anacleto-pt/Seismic-Table/README.md

# Seismic-Table
In this repository, you can find a fully detailed seismic table, materials list, and instructions on how to build your own.
