anacleto-pt/Seismic-Table/Mid Term Presentation/image-removebg-preview (2).png

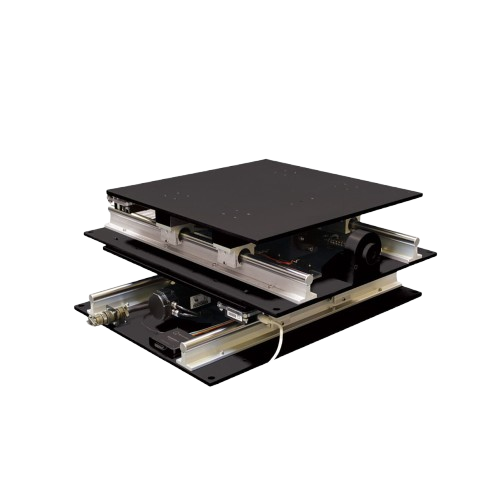
Mid Term Presentation/image-removebg-preview (2).png
