anacleto-pt/Seismic-Table/Sort/Desenho pinos ESP32.png

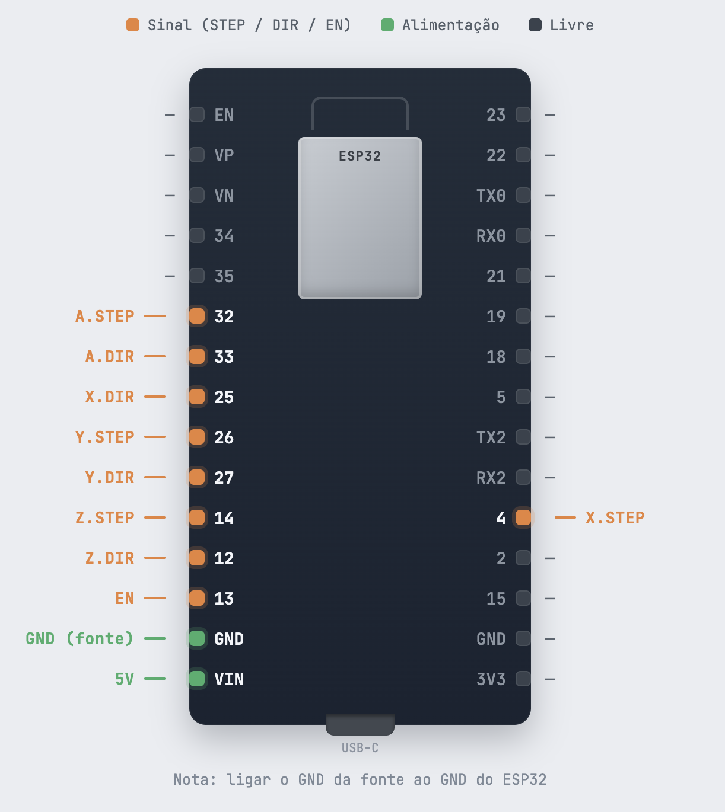
Sort/Desenho pinos ESP32.png
