anacleto-pt/Seismic-Table/Entrega/Partes3D/Base_Movel.stl

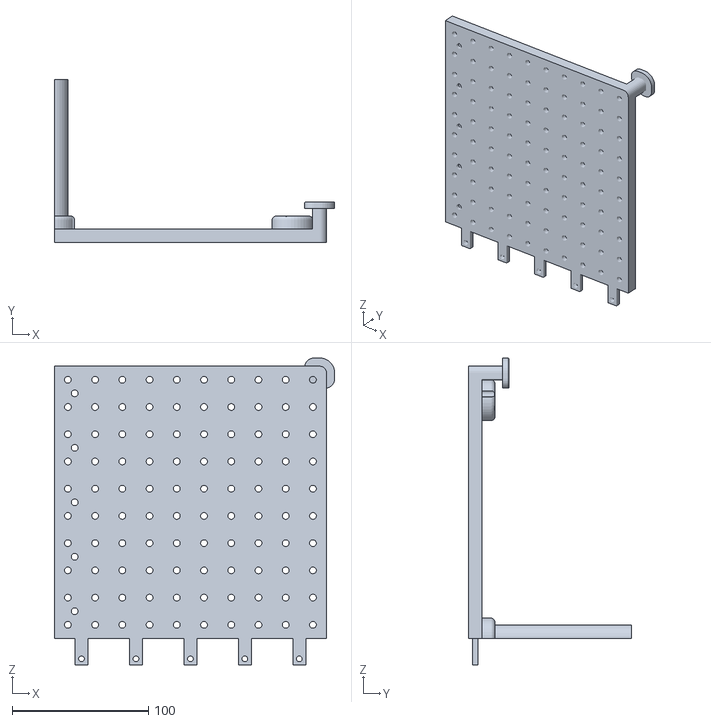
[picture p15: CAD file, 2026-06-26]
Entrega/Partes3D/Base_Movel.stl
206.0 x 120.0 x 225.5
