anacleto-pt/Seismic-Table/Entrega/Partes3D/Base_Fixa_Canto.stl

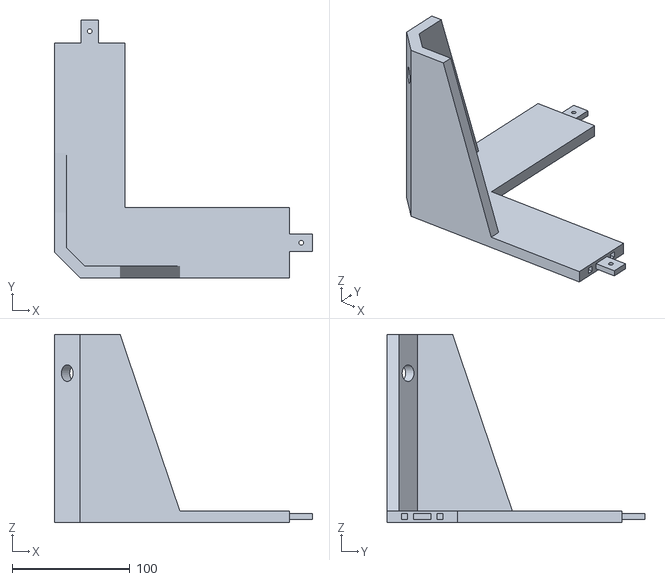
[picture p16: CAD file, 2026-06-26]
Entrega/Partes3D/Base_Fixa_Canto.stl
219.5 x 219.5 x 160.0
