anacleto-pt/Seismic-Table/Entrega/Partes3D/Coluna_Rotula.stl

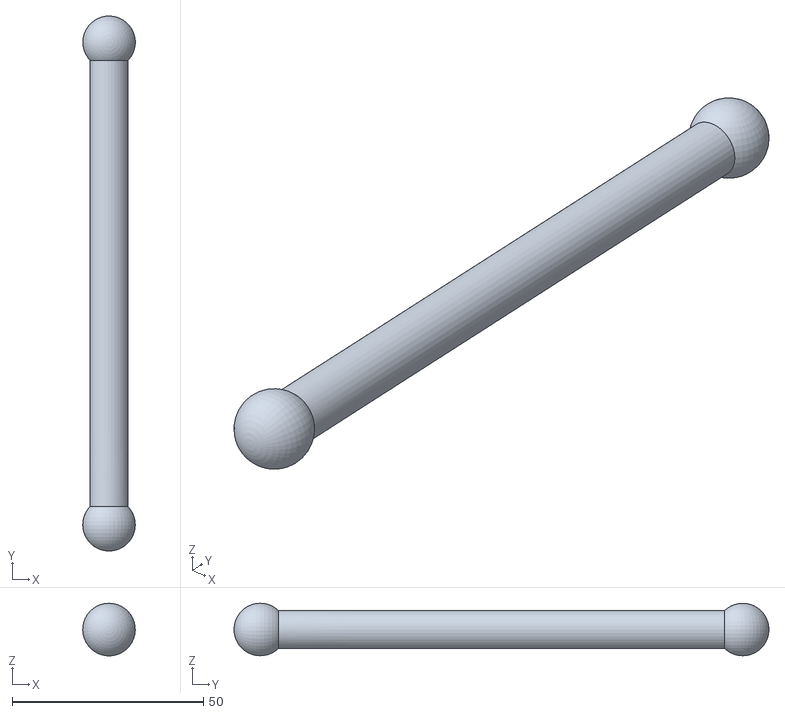
[picture p17: CAD file, 2026-06-26]
Entrega/Partes3D/Coluna_Rotula.stl
13.8 x 140.0 x 13.8
