anacleto-pt/Seismic-Table/Entrega/Partes3D/Suporte_Rotula.stl

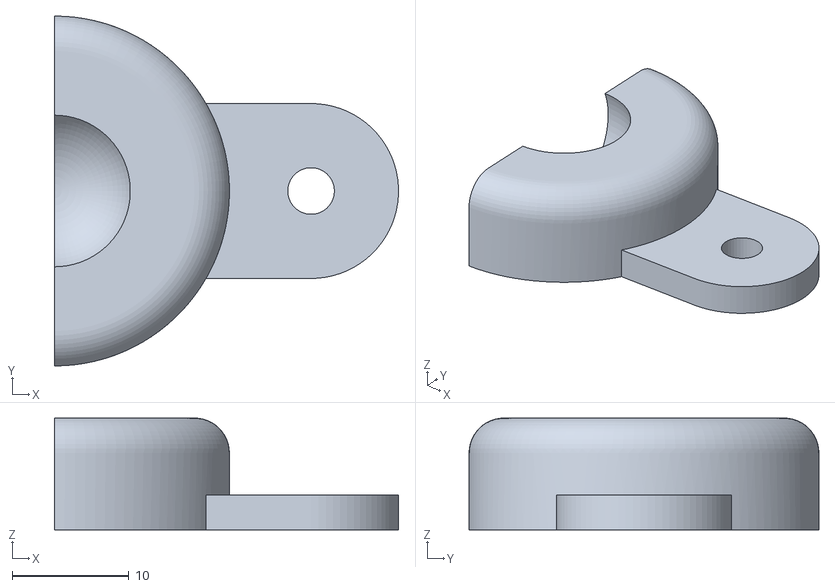
[picture p18: CAD file, 2026-06-26]
Entrega/Partes3D/Suporte_Rotula.stl
29.5 x 30.0 x 9.60
