anacleto-pt/Seismic-Table/Entrega/Partes3D/Base_Fixa_Centro.stl

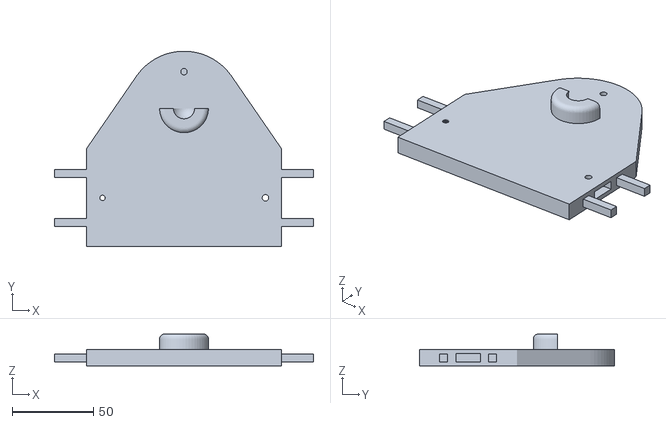
[picture p19: CAD file, 2026-06-26]
Entrega/Partes3D/Base_Fixa_Centro.stl
159.0 x 120.0 x 19.6
