anacleto-pt/Seismic-Table/Entrega/Partes3D/Suporte_Motor.stl

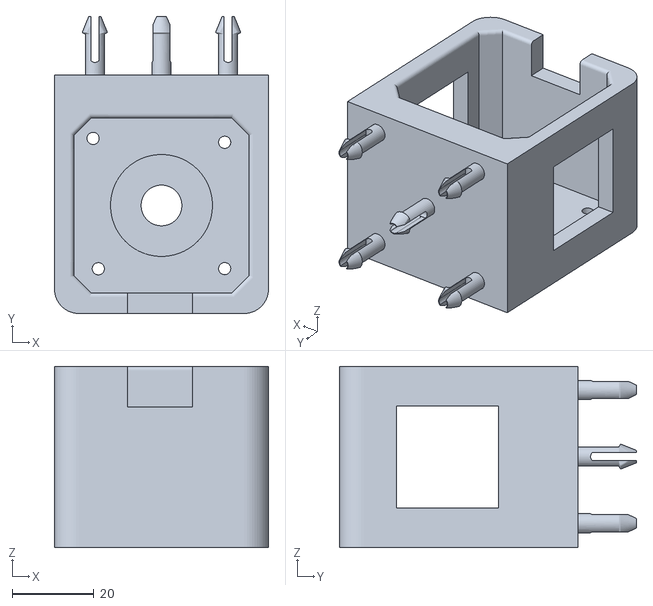
[picture p20: CAD file, 2026-06-23]
Entrega/Partes3D/Suporte_Motor.stl
52.5 x 72.8 x 44.5
