anacleto-pt/Seismic-Table/PDFs/schematic-Model.pdf

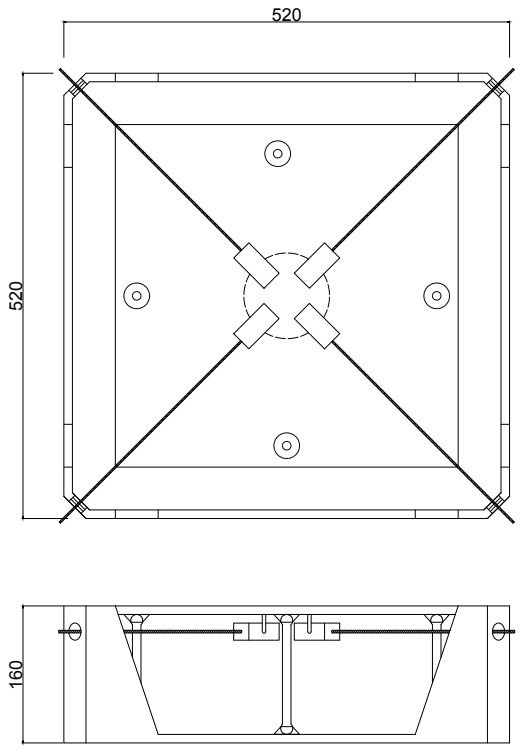
[picture p21: page 1]
