anacleto-pt/Seismic-Table/Entrega/Codigo/ESP|Cpp/MesaSismica_ElCentro.ino

#include <AccelStepper.h>

AccelStepper motorN(1, 4, 25);
AccelStepper motorE(1, 26, 27);
AccelStepper motorS(1, 14, 12);
AccelStepper motorW(1, 32, 33);

const int pinoEnable = 13;

// ============================================================
const int totalPontos = 1337;
// totalPontos = 1337
// Pos NS final: 1000 | Pos EW final: 422
// Intervalo firmware: 40ms

// --- N Data ---
int sismo_N[] = { 40, 40, 40, 40, 40, 29, 13, -6, -22, -33, -40, -40, -40, -40, -40, -40, -40, -40, -40, -40, -40, -40, -40, -40, -40, -40, -17, 33, 40, 40, 40, 7, -17, -10, 28, 40, 40, 40, 40, 40, 40, 40, 40, 40, 40, -40, -40, -40, -40, -40, -40, -40, 40, 40, 40, 40, 40, 40, 40, 40, 40, 40, 40, 40, 40, 40, -40, -40, -40, -40, -40, -40, -40, -40, -40, -40, -40, -40, -40, -40, -40, -40, -40, -3, -14, -40, -40, -40, -40, -40, -40, -40, -40, -40, -40, -40, -40, -40, -40, -40, -40, -28, 0, 0, 0, 40, 40, 40, 40, 40, 40, 40, 40, 40, 30, 2, 40, 40, 40, 40, 40, 40, 40, 40, 40, 40, 30, -40, -40, -40, -40, -40, -40, -40, -40,-40, -40, -40, -40, -40, -40, -40, -40, -40, -25, -8, -16, -32, -40, -21, 2, 0, -2, 0, 0, 15, 40, 40, 40, 40, 40, 40, 40, 15, -2, -10, -7, -11, -17, -22, -13, 21, 40, 40, 40, 40, 32, 16, 28, 40, 40, 35, 26, 31, 40, 40, 40, 40, 40, 40, 40, 40, 40, 40, 40, 40, 40, 40, 40, 40, 40, 40, 40, 40, 40, 40, 40, 40, 40, 40, 40, 40, 40, 40, 40, -29, -40, -40, -40, -40, -40, -40, -40, -40, 13, 2, -32, -40, -40, -40, -40, -29, 25, 40, 3, -40, -40, -40, -40, -18, -18, 2, 32, 11, 0, 12, 40, 40, 40, 40, 40, 40, 40, 40, 40, 40, 40, 40, 40, 40, 40, 40, 40, 40, 9, 0, 0, 0, 0, 0, -14, -14, -19, -36, -26, 16, 37, 15, -2, 9, 18, -15, -40,-40, -40, -40, -40, -40, -40, -40, -40, -40, -40, -40, -40, 0, 40, 40, 40, 40, 40, 11, -40, -40, -40, -40, -40, -40, -40, -40, -40, -40, -40, -40, -40, -40, -40, -40, -40, -40, -40, -40, -40, -40, -36, -13, 25, 40, 40, 40, 40, 40, 40, 40, 40, 40, 40, 40,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
int sismo_N_len = 1337;

// --- E Data ---
int sismo_E[] = { 40, 40, 40, 40, 40, 40, 40, 40, 40, 40, 40, 40, 40, 40, 40, 40, 40, 40, 40, 40, 40, 40, 40, 40, 40, 0, 0, -16, -36, -40, -40, -11, 6, -34, -40, -40, -40, -40, -40, -40, -40, -40, -40, -40, -40, -40, -40, -40, -40, -40, -40, -40, -40, -40, -40, -40, -40, -40, -40, -40, -40, -40, -40, -40, -40, -40, -40, -40, -40, -40, -40, -40, -40, -40, -24, 18, 40, 40, 40, 40, 40, 40, 40, 40, 40, 40, 40, 40, 40, 40, 40, 40, 40, 40, 40, 40, 40, 40, 40, 40, 40, 40, 40, 40, 32, -40, -40, -15, 40, 40, 40, 40, 40, 40, 40, 40, 40, -40, -40, -40, -40, -40, 4, 40, 40, 40, 40, 40, 40, 40, 40, 40, 40, 40, 40, 40, 36, 0, 0, 0, 0, 0, 0, 0, 0, 0, 0, 0, 0, 0, 0, 0, 0, 0, 0, 0, 0, 0, 0, 0, 0, 0, 0, 0, 0, 0, 0, 0, 0, 0, 0, 0, 0, -28, -40, -1, 40, 29, -20, -40, -40, -40, -40, -40, 3, 40, 40, 13, -27, -40, -40, -40, -40, -40, -28, -12,-21, -40, -40, -40, -40, -40, -40, -40, -40, -40, -40, -40, -40, -40, -40, -40, -40, -40, -40, -40, -40, -40, -40, -40, -40, -40, -40, -40, -40, -40, -2, 40, 40, 40, 40, 40, 40, 40, 40, 40, 40, 40, 40, 40, 40, 40, 40, 40, 32, 31, 40, 40, 40, 40, 40, -19, -40, -40, -40, 5, 11, 5, 35, 40, 40, 34, 10, -8, -12, -20, -40, -40, -40, -40, -40, -25, 1, -9, -10, 36, 40, 40, 35, -40, -40, -40, -40, -40, -40, -40, 40, 40, 40, 40, 40, 40, 40, 40, 40, 40, 40, 40, 40, 40, 40, 24, -18, -40, -40, -40, -40, -40, -40, -40, -40, -40, -40, -40, -40, -40, -40, -40, -40, -40, -32, -6, 6, 9, 6, 0, -23, -31, -9, 6, -9, -33, -40, -40, -40, -40, -40, -40, -40, -40, -40, -40, -40, -40, -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
int sismo_E_len = 1337;

// --- S Data ---
int sismo_S[] = { -40, -40, -40, -40, -40, -29, -13, 6, 22, 33, 40, 40, 40, 40, 40, 40, 40, 40, 40, 40, 40, 40, 40, 40, 40, 40, 17, -33, -40, -40, -40, -7, 17, 10, -28, -40, -40, -40, -40, -40, -40, -40, -40, -40, -40, 40, 40, 40, 40, 40, 40, 40, -40, -40, -40, -40, -40, -40, -40, -40, -40, -40, -40, -40, -40, -40, 40, 40, 40, 40, 40, 40, 40, 40, 40, 40, 40, 40, 40, 40, 40, 40, 40, 3, 14, 40, 40, 40, 40, 40, 40,40, 40, 40, 40, 40, 40, 40, 40, 40, 40, 28, 0, 0, 0, -40, -40, -40, -40, -40, -40, -40, -40, -40, -30, -2, -40, -40, -40, -40, -40, -40, -40, -40, -40, -40, -30, 40, 40, 40, 40, 40, 40, 40, 40, 40, 40, 40, 40, 40, 40, 40, 40, 40, 25, 8, 16, 32, 40, 21, -2, 0, 2, 0, 0, -15, -40, -40, -40, -40, -40, -40, -40, -15, 2, 10, 7, 11, 17, 22, 13, -21, -40, -40, -40, -40, -32, -16, -28, -40, -40, -35, -26, -31, -40, -40, -40, -40, -40, -40, -40, -40, -40, -40, -40, -40, -40, -40, -40, -40, -40, -40, -40, -40, -40, -40, -40, -40, -40, -40, -40, -40, -40, -40, -40, 29, 40, 40, 40, 40, 40, 40, 40, 40, -13, -2, 32, 40, 40, 40, 40, 29, -25, -40, -3, 40, 40, 40, 40, 18, 18, -2, -32, -11, 0, -12, -40, -40, -40, -40, -40, -40, -40, -40, -40, -40, -40, -40, -40, -40, -40, -40, -40, -40, -9, 0, 0, 0, 0, 0, 14, 14, 19, 36, 26, -16, -37, -15, 2, -9, -18, 15, 40, 40, 40, 40, 40, 40, 40, 40, 40, 40, 40, 40, 40, 0, -40, -40, -40, -40, -40, -11, 40, 40, 40, 40, 40, 40, 40, 40, 40, 40, 40, 40, 40, 40, 40, 40, 40, 40, 40, 40, 40, 40, 36, 13, -25, -40,-40, -40, -40, -40, -40, -40, -40, -40, -40, -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
int sismo_S_len = 1337;

// --- W Data ---
int sismo_W[] = { -40, -40, -40, -40, -40, -40, -40, -40, -40, -40, -40, -40, -40, -40, -40, -40, -40, -40, -40, -40, -40, -40, -40, -40, -40, 0, 0, 16, 36, 40, 40, 11, -6, 34, 40, 40, 40, 40, 40, 40, 40, 40, 40, 40, 40, 40, 40, 40, 40, 40, 40, 40, 40, 40, 40, 40, 40, 40, 40, 40, 40, 40, 40, 40, 40, 40, 40, 40, 40, 40, 40, 40, 40, 40, 24, -18, -40, -40, -40, -40, -40, -40, -40, -40, -40, -40, -40, -40, -40, -40,-40, -40, -40, -40, -40, -40, -40, -40, -40, -40, -40, -40, -40, -40, -32, 40, 40, 15, -40, -40, -40, -40, -40, -40, -40, -40, -40, 40, 40, 40, 40, 40, -4, -40, -40, -40, -40, -40, -40, -40, -40, -40, -40, -40, -40, -40, -36, 0, 0, 0, 0, 0, 0, 0, 0, 0, 0, 0, 0, 0, 0, 0, 0, 0, 0, 0, 0, 0, 0, 0, 0, 0, 0, 0, 0, 0, 0, 0, 0, 0, 0, 0, 0, 28, 40, 1, -40, -29, 20, 40, 40, 40, 40, 40, -3, -40, -40, -13, 27, 40, 40, 40, 40, 40, 28, 12, 21, 40, 40, 40, 40, 40, 40, 40, 40, 40, 40, 40, 40, 40, 40, 40, 40, 40, 40, 40, 40, 40, 40, 40, 40, 40, 40, 40, 40, 40, 2, -40, -40, -40, -40, -40, -40, -40, -40, -40, -40, -40, -40, -40, -40, -40, -40, -40, -32, -31, -40, -40, -40, -40, -40, 19, 40, 40, 40, -5, -11, -5, -35, -40, -40, -34, -10, 8, 12, 20, 40, 40, 40, 40, 40, 25, -1, 9, 10, -36, -40, -40, -35, 40, 40, 40, 40, 40, 40, 40, -40, -40, -40, -40, -40, -40, -40, -40, -40, -40, -40, -40, -40, -40, -40, -24, 18, 40, 40, 40, 40, 40, 40, 40, 40, 40, 40, 40, 40, 40, 40, 40, 40, 40, 32, 6, -6, -9, -6, 0, 23, 31, 9, -6, 9, 33, 40, 40, 40, 40, 40, 40, 40, 40, 40, 40, 40, 40, 40, 40, 40, 40, 40, 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
int sismo_W_len = 1337;
// ============================================================

bool sismoLigado = false;
int indiceAtual = 0;
unsigned long ultimoUpdate = 0;
unsigned long tempoInicioSismo = 0;

void setup() {
  Serial.begin(115200);
  pinMode(pinoEnable, OUTPUT);

  motorN.setMaxSpeed(60000);
  motorE.setMaxSpeed(60000);
  motorS.setMaxSpeed(60000);
  motorW.setMaxSpeed(60000);

  digitalWrite(pinoEnable, HIGH);

  Serial.println("Envia qualquer tecla + Enter para iniciar simulação sísmica...");
}

void loop() {
  if (!sismoLigado) {
    if (Serial.available() > 0) {
      while (Serial.available()) Serial.read();
      digitalWrite(pinoEnable, LOW);
      delay(50);
      indiceAtual = 0;
      sismoLigado = true;
      tempoInicioSismo = millis();
      ultimoUpdate = millis();
      Serial.println("tempo_s,velN,velE,velS,velW");
      Serial.println(">>> INÍCIO DA SIMULAÇÃO SÍSMICA <<<");
    }
    return;
  }

  if (millis() - ultimoUpdate >= 40) {
    ultimoUpdate = millis();

    if (indiceAtual < totalPontos) {
      float tempoAtual = (millis() - tempoInicioSismo) / 1000.0;

      float velN = (float)sismo_N[indiceAtual] / 0.04;
      float velE = (float)sismo_E[indiceAtual] / 0.04;
      float velS = (float)sismo_S[indiceAtual] / 0.04;
      float velW = (float)sismo_W[indiceAtual] / 0.04;

      motorN.setSpeed(velN);
      motorE.setSpeed(velE);
      motorS.setSpeed(velS);
      motorW.setSpeed(velW);

      Serial.print(tempoAtual, 3); Serial.print(",");
      Serial.print(velN, 0);       Serial.print(",");
      Serial.print(velE, 0);       Serial.print(",");
      Serial.print(velS, 0);       Serial.print(",");
      Serial.println(velW, 0);

      indiceAtual++;
    } else {
      sismoLigado = false;
      motorN.setSpeed(0); motorE.setSpeed(0);
      motorS.setSpeed(0); motorW.setSpeed(0);
      digitalWrite(pinoEnable, HIGH);
      Serial.println("--- SIMULAÇÃO SÍSMICA TERMINADA ---");
    }
  }

  motorN.runSpeed();
  motorE.runSpeed();
  motorS.runSpeed();
  motorW.runSpeed();
}
