anacleto-pt/Seismic-Table/(commit log)

2026-04-23 Work done before creating the repository
    [EW.csv, NS.csv, elcentro_eq_disp.xlsx]
2026-04-24 Small updates - Commiting to work on a different computer
    [EW.csv]
2026-04-24 Functions Done, changing layout to havethe poles on the edges and not on the faces
    [NS.csv]
2026-06-23 folder rearangement
    [Caixa motor v2.3mf.3mf, Caixa motor.stl, schematic 1.dwg, teste snap fit joint.dwg]
2026-06-26 Final version
    [Base_Fixa_Canto.stl, Base_Fixa_Centro.stl, Base_Movel.stl, Caixa motor.stl, Coluna_Rotula.stl, EW.csv, NS.csv, Suporte_Motor.stl]
